TIEN3915/GIMBAL/STM32F4_GIMBAL_BOARD/Images/Ảnh chụp màn hình 2024-11-24 223947.png

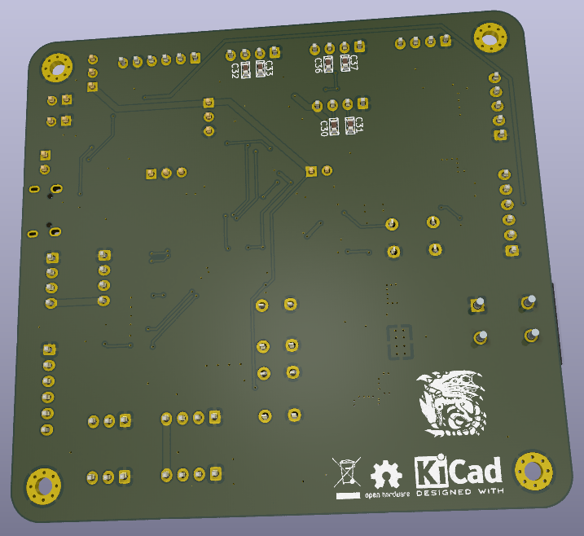
STM32F4_GIMBAL_BOARD/Images/Ảnh chụp màn hình 2024-11-24 223947.png
