TIEN3915/GIMBAL/STM32F4_GIMBAL_BOARD/STM32F4_GIMBAL_BOARD.kicad_pcb

## KiCad design STM32F4_GIMBAL_BOARD/STM32F4_GIMBAL_BOARD.kicad_pcb (2024-12-04)

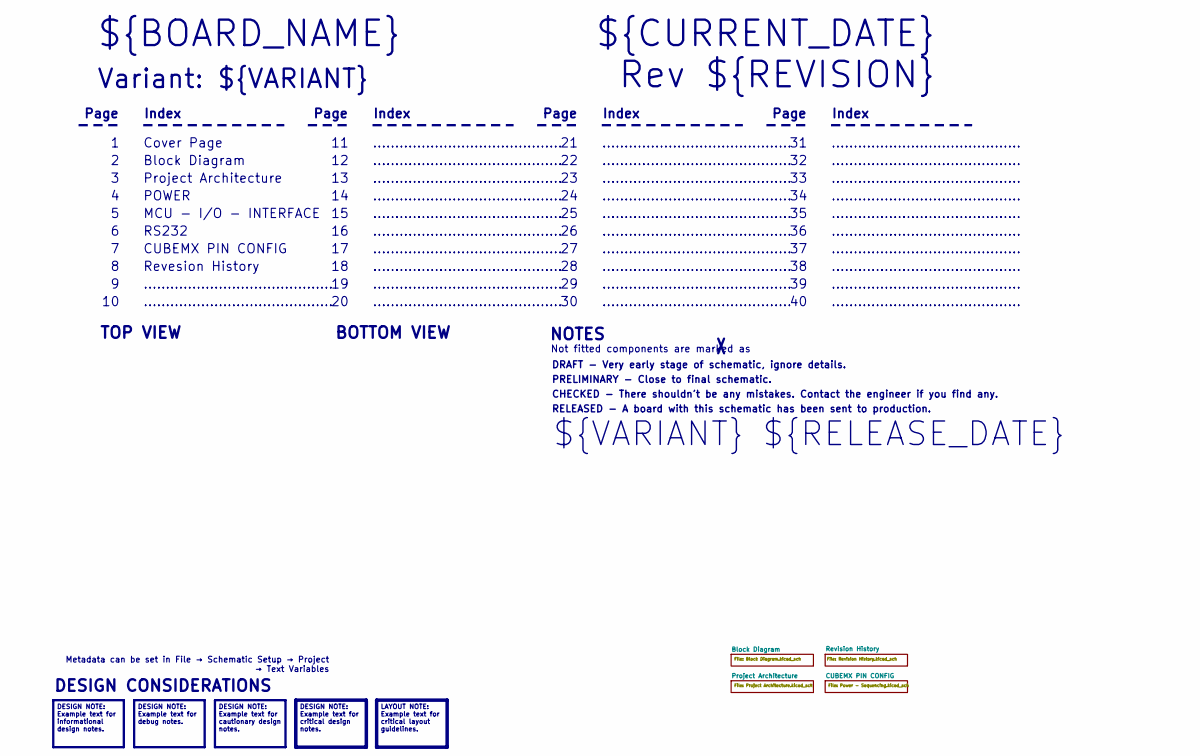
[picture p3: schematic STM32F4_GIMBAL_BOARD.kicad_sch, Cover Page]

Notes on the sheet:
Metadata can be set in File → Schematic Setup → Project → Text Variables
DESIGN NOTE: Example text for informational design notes.
LAYOUT NOTE: Example text for critical layout guidelines.
DESIGN NOTE: Example text for cautionary design notes.
DESIGN NOTE: Example text for debug notes.
DESIGN NOTE: Example text for critical design notes.
BOTTOM VIEW
...........................................
RELEASED - A board with this schematic has been sent to production.
Page
TOP VIEW
Revesion History
Not fitted components are marked as
Index
PRELIMINARY - Close to final schematic.
${VARIANT} ${RELEASE_DATE}
POWER
${CURRENT_DATE}
Variant: ${VARIANT}
Rev ${REVISION}
MCU - I/O - INTERFACE
${BOARD_NAME}
DRAFT - Very early stage of schematic, ignore details.
RS232
Block Diagram
Cover Page
NOTES
Project Architecture
CHECKED - There shouldn't be any mistakes. Contact the engineer if you find any.
DESIGN CONSIDERATIONS
CUBEMX PIN CONFIG

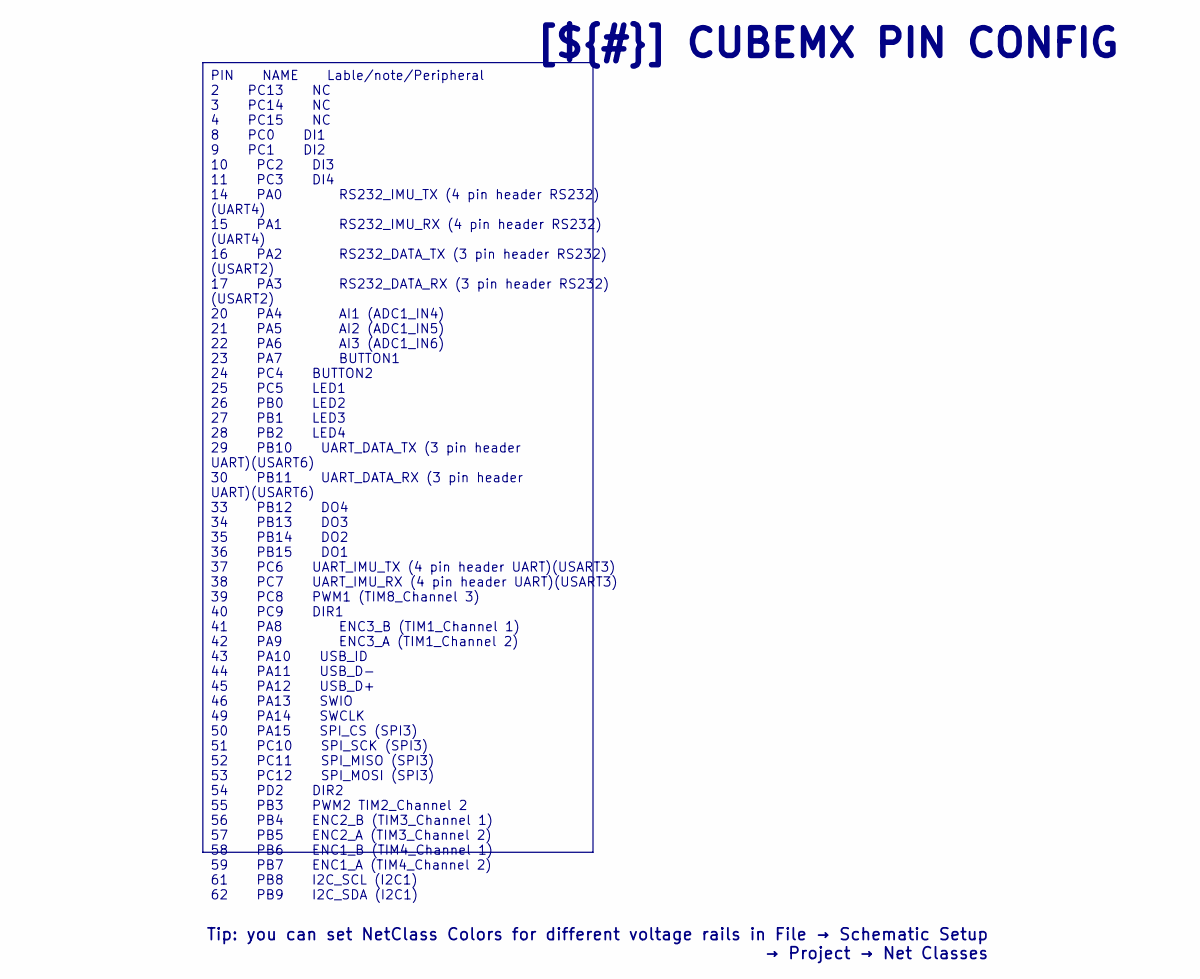
[picture p4: schematic Power - Sequencing.kicad_sch, CUBEMX PIN CONFIG]

Notes on the sheet:
PIN NAME Lable/note/Peripheral 2 PC13 NC 3 PC14 NC 4 PC15 NC 8 PC0 DI1 9 PC1 DI2 10 PC2 DI3 11 PC3 DI4 14 PA0 RS232_IMU_TX (4 pin header RS232) (UART4) 15 PA1 RS232_IMU_RX (4 pin header RS232) (UART4) 16 PA2 RS232_DATA_TX (3 pin header RS232) (USART2) 17 PA3 RS232_DATA_RX (3 pin header RS232) (USAR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
[${#}] ${TITLE}
Tip: you can set NetClass Colors for different voltage rails in File → Schematic Setup → Project → Net Classes

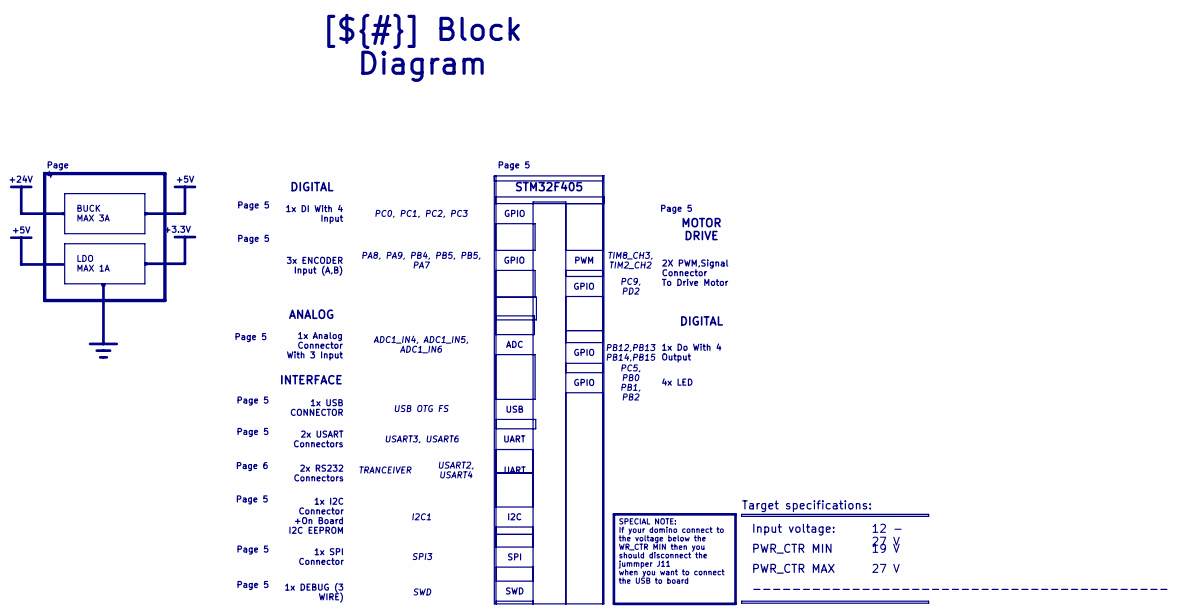
[picture p5: schematic Block Diagram.kicad_sch]

Notes on the sheet:
PWR_CTR MAX
LDO MAX 1A
GPIO
TRANCEIVER
GPIO
Page 6
PWR_CTR MIN
PA8, PA9, PB4, PB5, PB5, PA7
STM32F405
USART3, USART6
PC5, PB0 PB1, PB2
1x I2C Connector +On Board I2C EEPROM
Page 5
TIM8_CH3, TIM2_CH2
2x USART Connectors
Input voltage:
PC0, PC1, PC2, PC3
UART
19 V
SWD
PC9, PD2
1x Analog Connector With 3 Input
ADC1_IN4, ADC1_IN5, ADC1_IN6
MOTOR DRIVE
1x DEBUG (3 WIRE)
SPI
1x DI With 4 Input
SWD
1x SPI Connector
4x LED
USART2, USART4
2X PWM,Signal Connector To Drive Motor
Page 5
[${#}] ${TITLE}
Page 4
Target specifications:
SPI3
2x RS232 Connectors
27 V
ADC
DIGITAL
SPECIAL NOTE: If your domino connect to the voltage below the WR_CTR MIN then you should disconnect the jummper J11 when you want to connect the USB to board
INTERFACE
12 - 27 V
I2C
USB
PB12,PB13 PB14,PB15
1x USB CONNECTOR
USB OTG FS
PWM
3x ENCODER Input (A,B)
ANALOG
I2C1
------------------------------------------
BUCK MAX 3A
1x Do With 4 Output
+5V
+3.3V
+24V

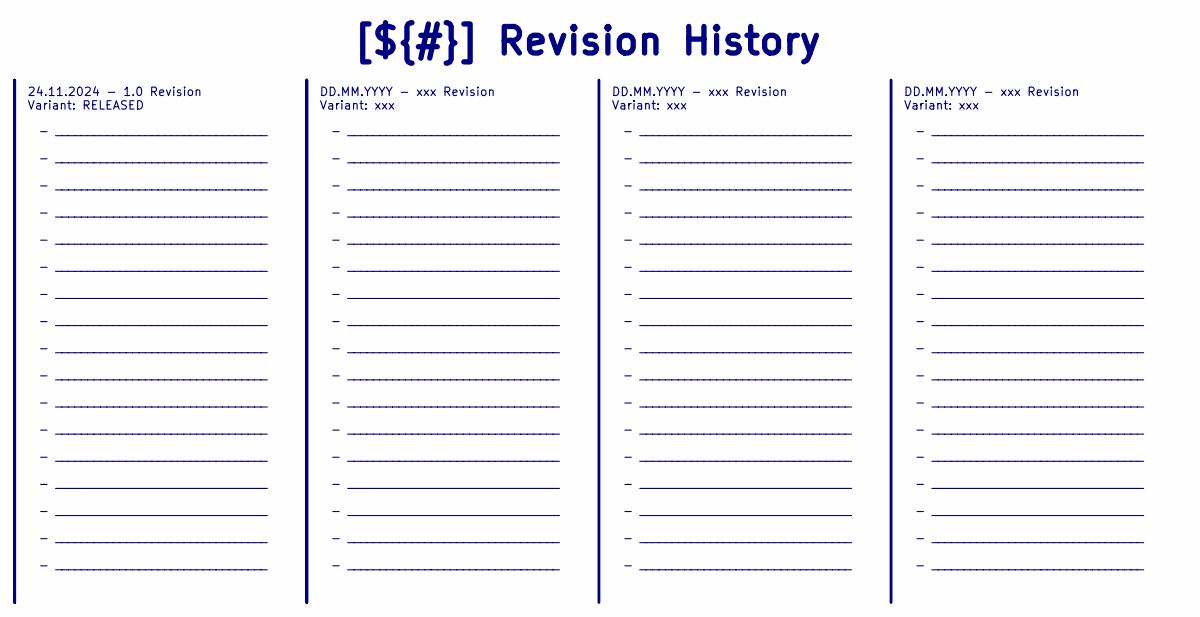
[picture p6: schematic Revision History.kicad_sch]

Notes on the sheet:
- _________________________________ - _________________________________ - _________________________________ - _________________________________ - _________________________________ - _________________________________ - _________________________________ - _________________________________ - _________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
DD.MM.YYYY - xxx Revision Variant: xxx
[${#}] ${TITLE}
24.11.2024 - 1.0 Revision Variant: RELEASED

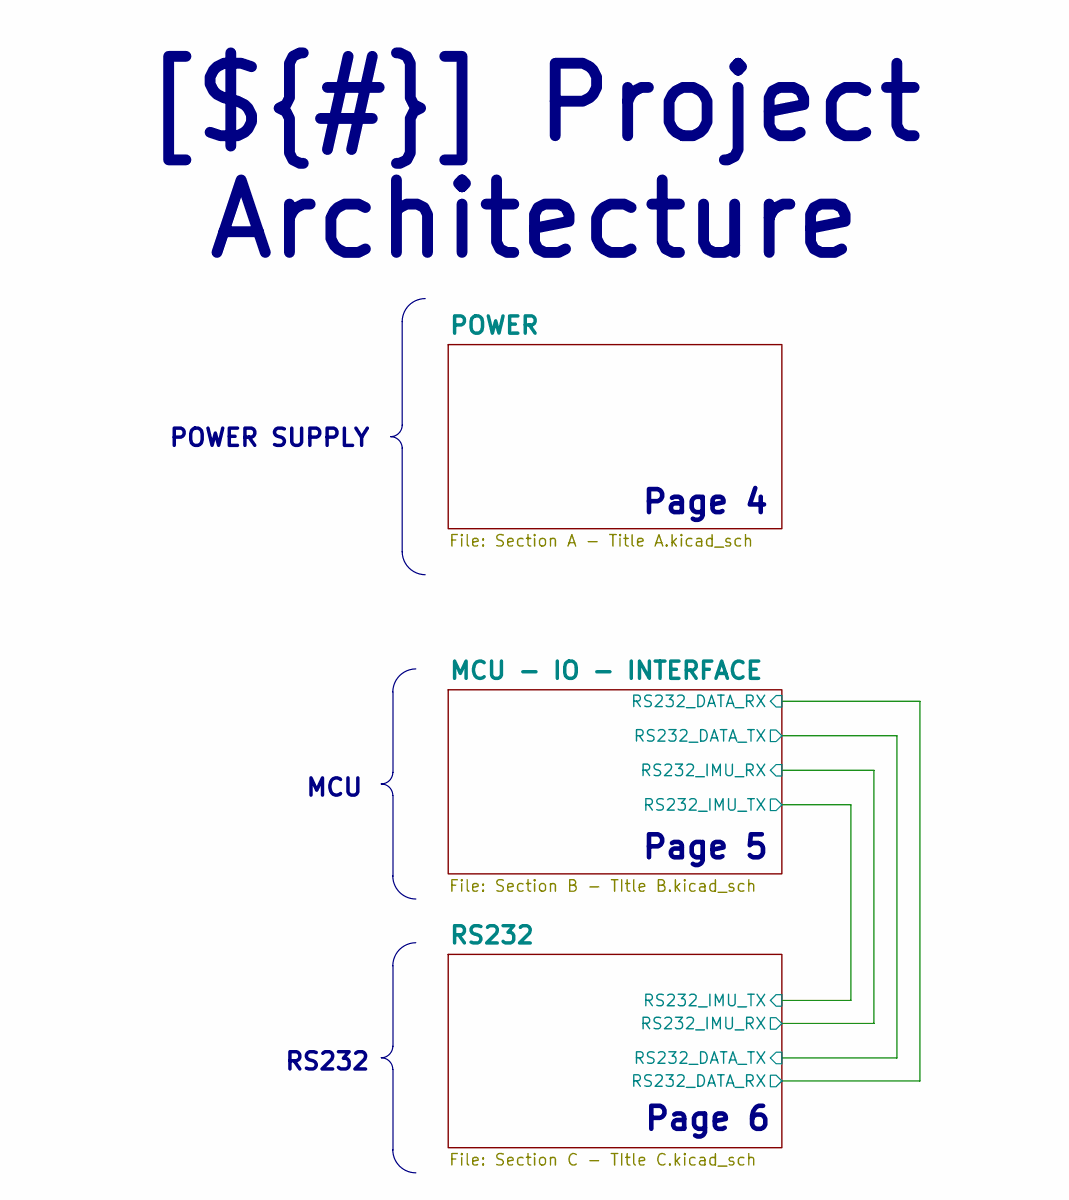
[picture p7: schematic Project Architecture.kicad_sch]

Notes on the sheet:
RS232
POWER SUPPLY
[${#}] ${TITLE}
MCU
Page 4
Page 6
Page 5

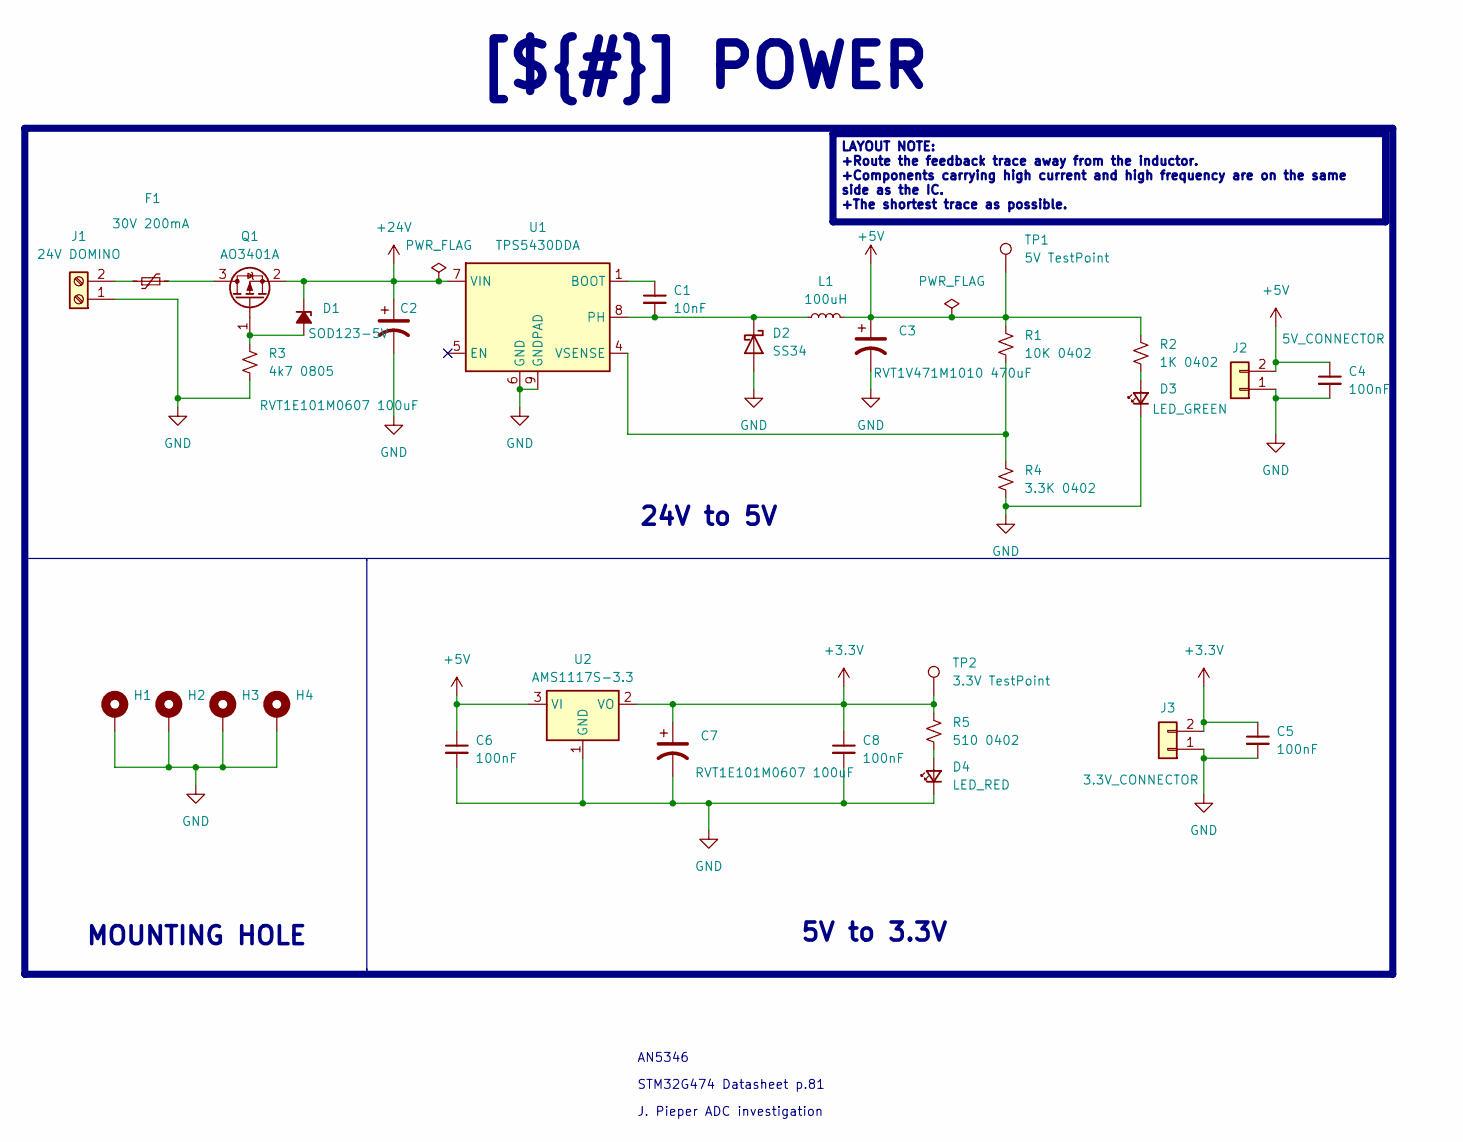
[picture p8: schematic Section A - Title A.kicad_sch, POWER]

Parts:
C1: 10nF; C_0402_1005Metric
C2, C7: RVT1E101M0607 100uF; CP_Elec_6.3x7.7
C3: RVT1V471M1010 470uF; CP_Elec_10x10.5
C4, C5, C6, C8: 100nF; C_0402_1005Metric
D1: SOD123-5V; D_SOD-123
D2: SS34; D_SMA
D3: LED_GREEN; LED_0603_1608Metric
D4: LED_RED; LED_0603_1608Metric
F1: 30V 200mA; Fuse_1812_4532Metric
H1, H2, H3, H4: MountingHole_Pad; MountingHole_2.7mm_M2.5_Pad_Via
J1: 24V DOMINO; KF142R5082P
J2: 5V_CONNECTOR; PinHeader_1x02_P2.54mm_Vertical
J3: 3.3V_CONNECTOR; PinHeader_1x02_P2.54mm_Vertical
L1: 100uH; L_12x12mm_H8mm
Q1: AO3401A; SOT-23
R1: 10K 0402; R_0402_1005Metric
R2: 1K 0402; R_0402_1005Metric
R3: 4k7 0805; R_0805_2012Metric
R4: 3.3K 0402; R_0402_1005Metric
R5: 510 0402; R_0402_1005Metric
TP1: 5V TestPoint; TestPoint_Pad_2.0x2.0mm
TP2: 3.3V TestPoint; TestPoint_Pad_2.0x2.0mm
U1: TPS5430DDA; TI_SO-PowerPAD-8_ThermalVias
U2: AMS1117S-3.3; SOT-223-3_TabPin2

Connections:
+3.3V: C5.1, C7.1, C8.1, J3.2, R5.1, TP2.1, U2.2 (VO); also elsewhere on the board
+5V: C3.1, C4.1, C6.1, J2.2, L1.2, R1.1, R2.1, TP1.1, U2.3 (VI); also elsewhere on the board
+24V: C2.1, D1.1 (K), Q1.2 (S), U1.7 (VIN); also elsewhere on the board
GND: C2.2, C3.2, C4.2, C5.2, C6.2, C7.2, C8.2, D2.2 (A), D3.1 (K), D4.1 (K), H1.1, H2.1, H3.1, H4.1, J1.1, J2.1, J3.1, R3.2, R4.2, U1.6 (GND), U1.9 (GNDPAD), U2.1 (GND); also elsewhere on the board
unnamed: D1.2 (A), Q1.1 (G), R3.1
unnamed: C1.2, D2.1 (K), L1.1, U1.8 (PH)
unnamed: D3.2 (A), R2.2
unnamed: D4.2 (A), R5.2
unnamed: F1.1, J1.2
unnamed: F1.2, Q1.3 (D)
unnamed: C1.1, U1.1 (BOOT)
unnamed: R1.2, R4.1, U1.4 (VSENSE)

Notes on the sheet:
MOUNTING HOLE
LAYOUT NOTE: +Route the feedback trace away from the inductor. +Components carrying high current and high frequency are on the same side as the IC. +The shortest trace as possible.
[${#}] ${TITLE}
5V to 3.3V
24V to 5V
J. Pieper ADC investigation
STM32G474 Datasheet p.81
AN5346

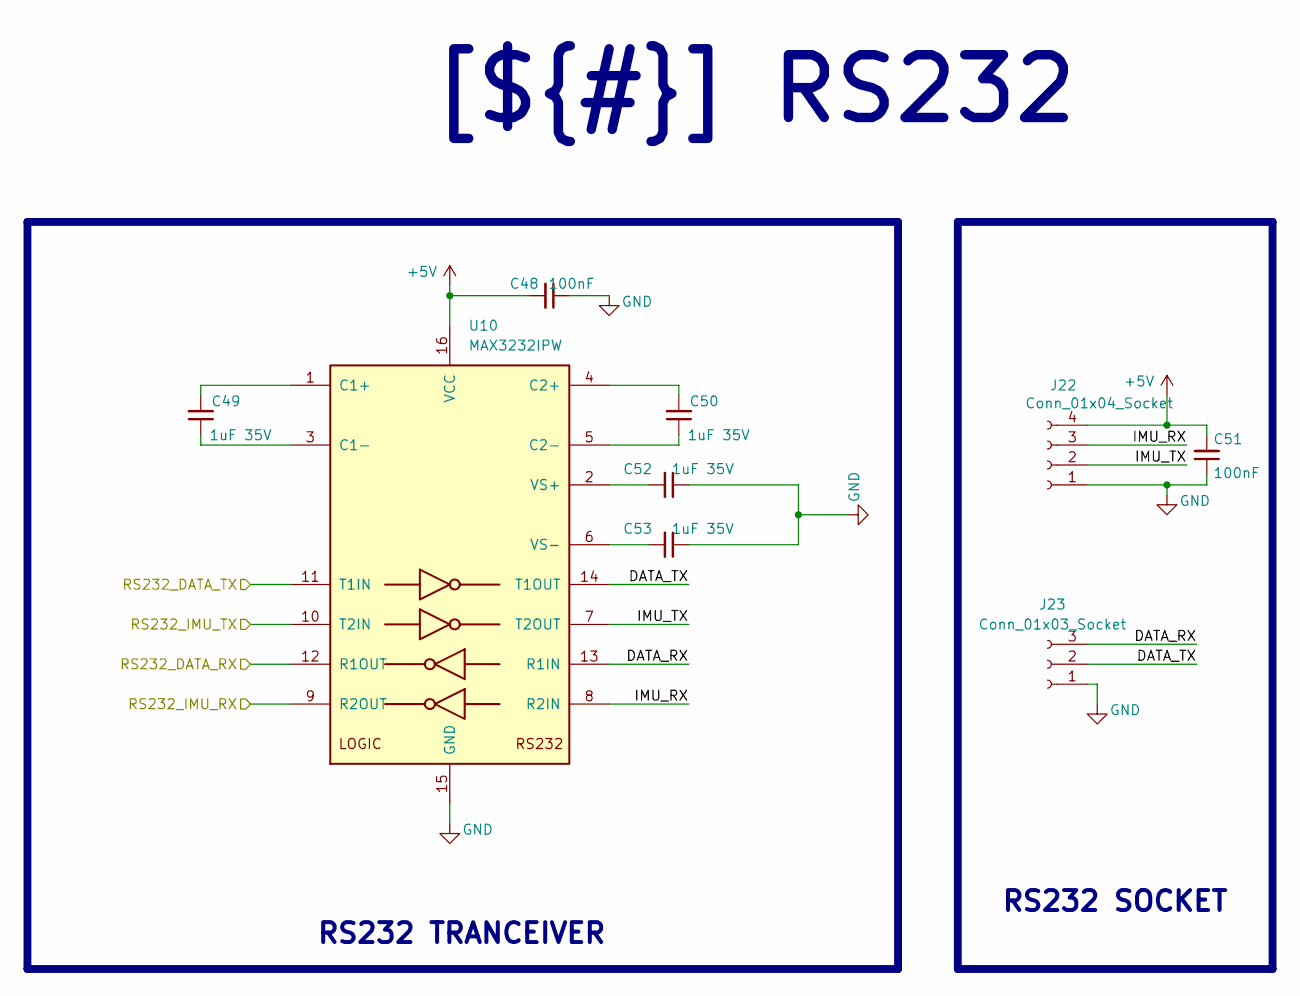
[picture p9: schematic Section C - TItle C.kicad_sch, RS232]

Parts:
C48, C51: 100nF; C_0402_1005Metric
C49, C50, C52, C53: 1uF 35V; C_0603_1608Metric
J22: Conn_01x04_Socket; JST_XH_B4B-XH-A_1x04_P2.50mm_Vertical
J23: Conn_01x03_Socket; JST_XH_B3B-XH-A_1x03_P2.50mm_Vertical
U10: MAX3232IPW; TSSOP-16_4.4x5mm_P0.65mm

Connections:
+5V: C48.2, C51.2, J22.4, U10.16 (VCC); also elsewhere on the board
/Project Architecture/MCU - IO - INTERFACE/RS232_DATA_RX: U10.12 (R1OUT); also elsewhere on the board
/Project Architecture/MCU - IO - INTERFACE/RS232_DATA_TX: U10.11 (T1IN); also elsewhere on the board
/Project Architecture/MCU - IO - INTERFACE/RS232_IMU_RX: U10.9 (R2OUT); also elsewhere on the board
/Project Architecture/MCU - IO - INTERFACE/RS232_IMU_TX: U10.10 (T2IN); also elsewhere on the board
/Project Architecture/RS232/DATA_RX: J23.3, U10.13 (R1IN)
/Project Architecture/RS232/DATA_TX: J23.2, U10.14 (T1OUT)
/Project Architecture/RS232/IMU_RX: J22.3, U10.8 (R2IN)
/Project Architecture/RS232/IMU_TX: J22.2, U10.7 (T2OUT)
GND: C48.1, C51.1, C52.1, C53.1, J22.1, J23.1, U10.15 (GND); also elsewhere on the board
unnamed: C49.2, U10.1 (C1+)
unnamed: C49.1, U10.3 (C1-)
unnamed: C50.2, U10.4 (C2+)
unnamed: C50.1, U10.5 (C2-)
unnamed: C52.2, U10.2 (VS+)
unnamed: C53.2, U10.6 (VS-)

Notes on the sheet:
RS232 TRANCEIVER
RS232 SOCKET
[${#}] ${TITLE}

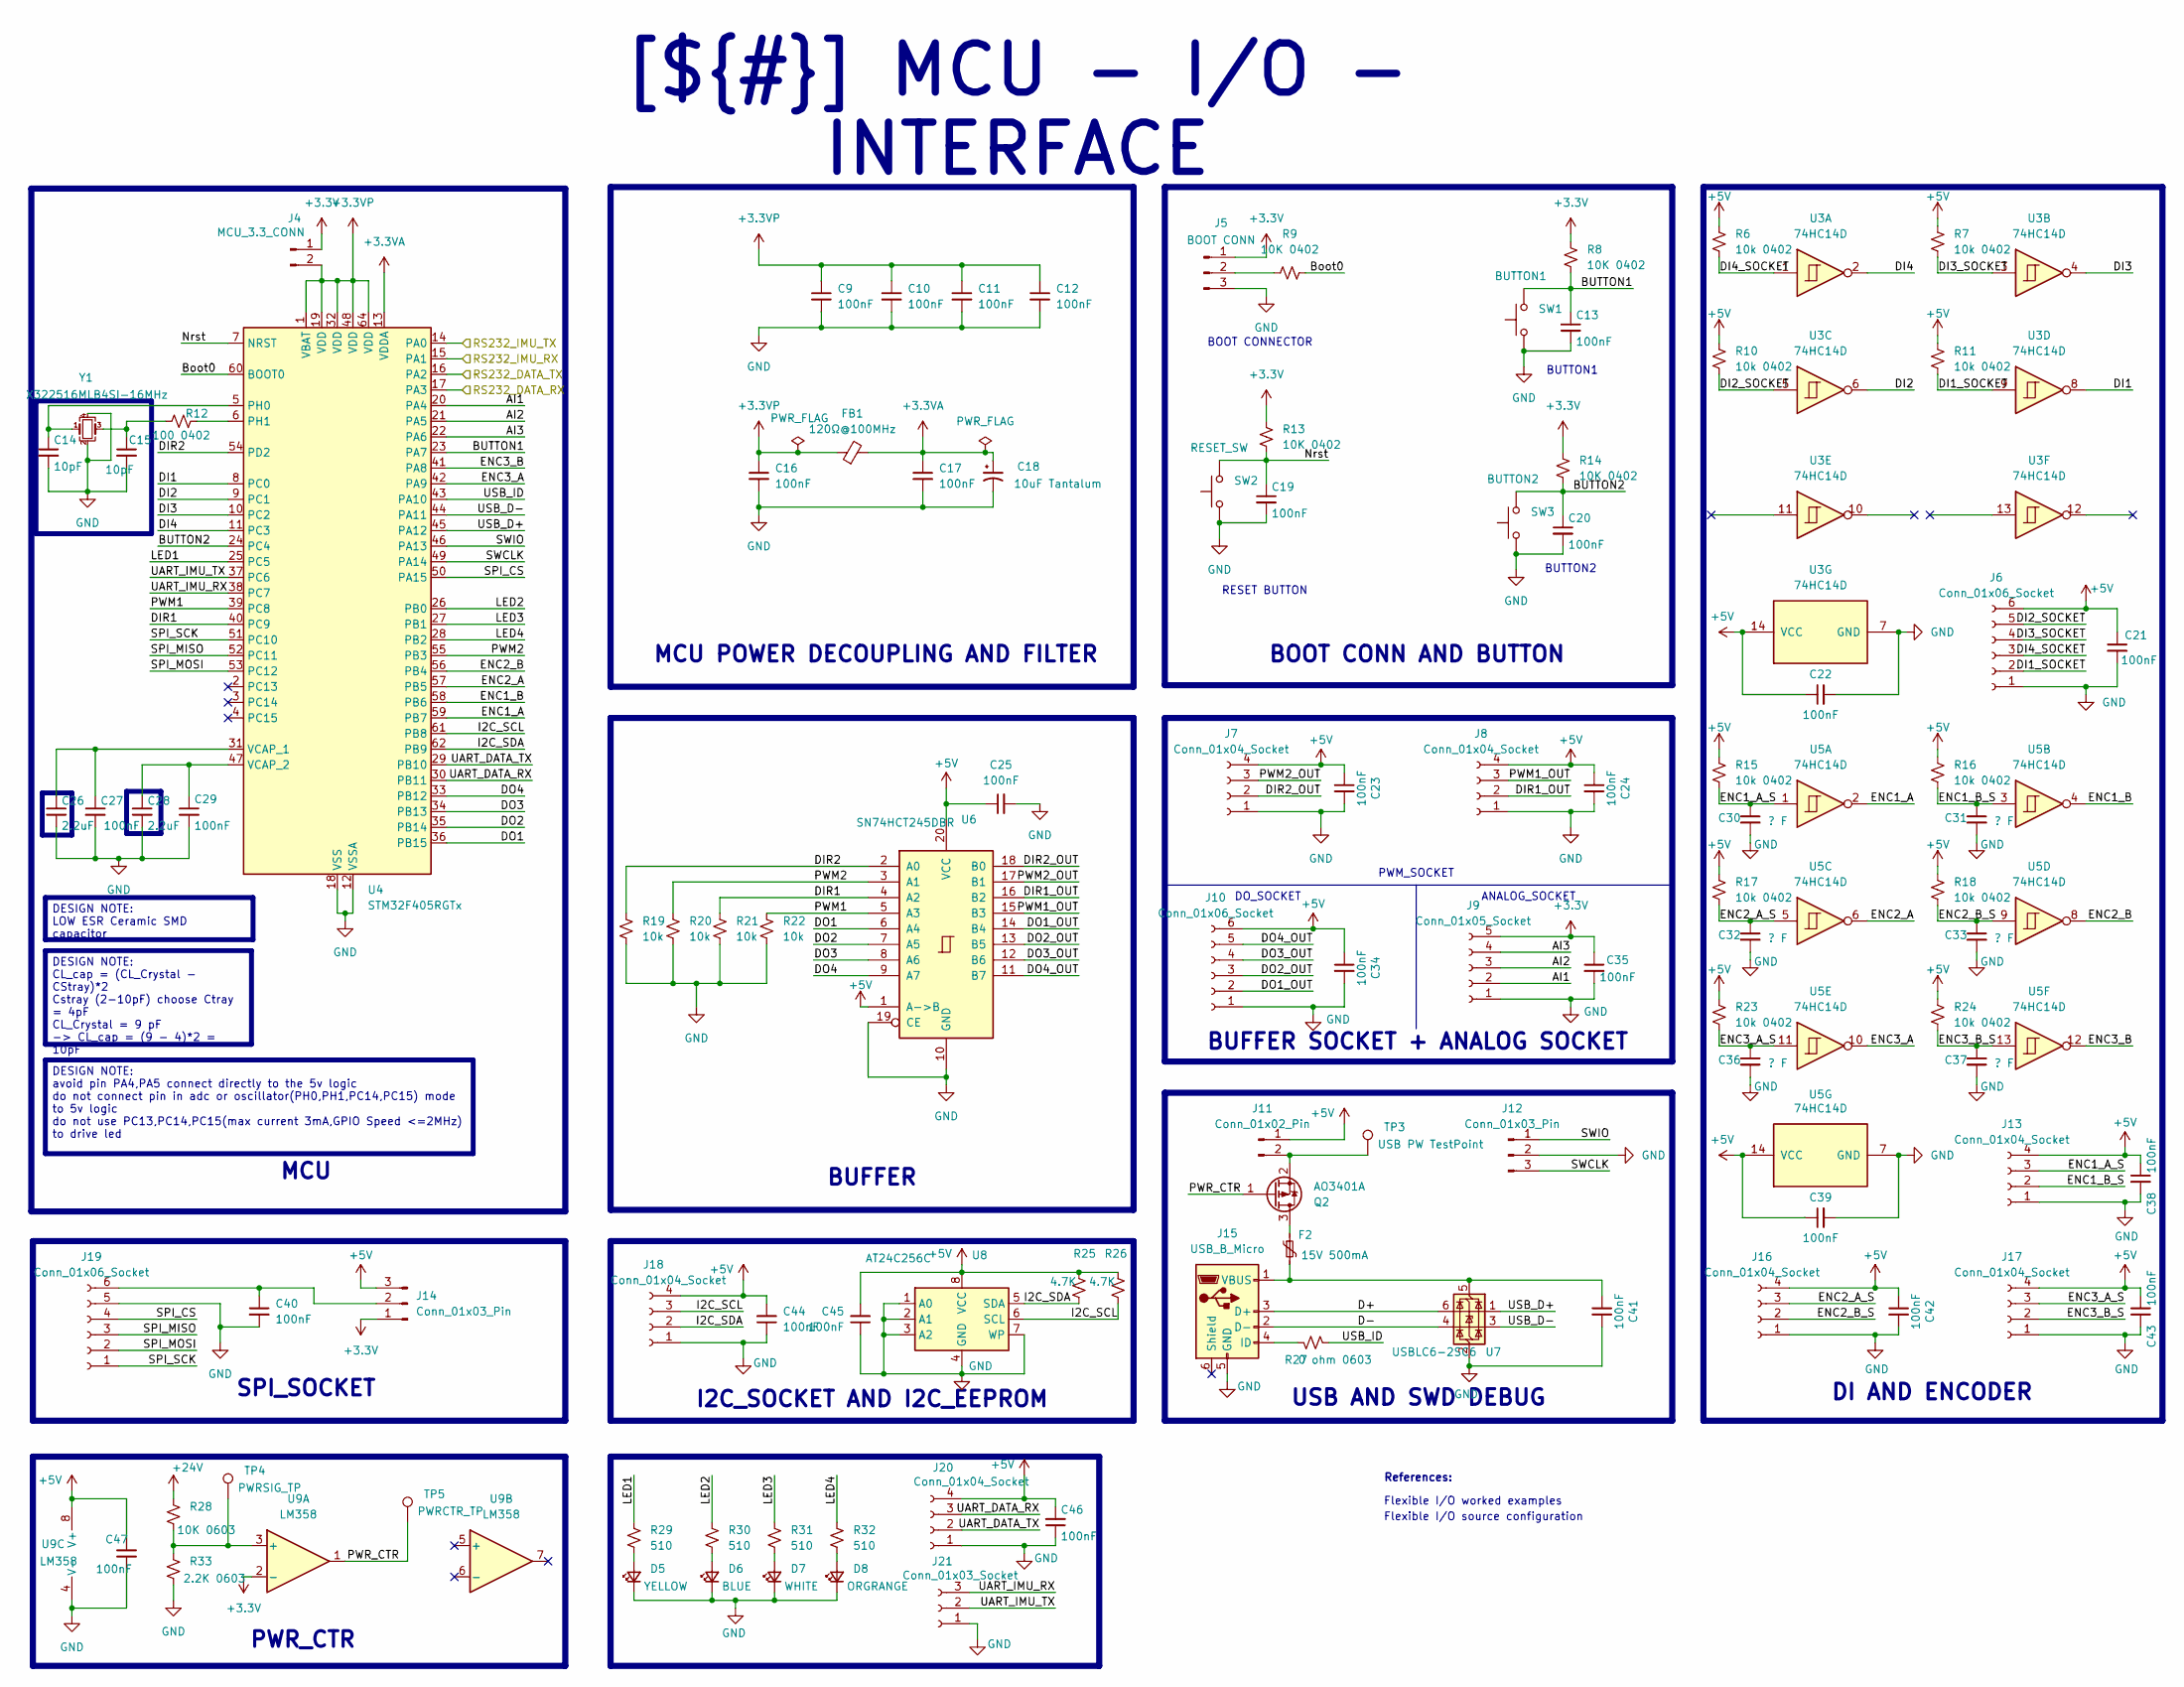
[picture p10: schematic Section B - TItle B.kicad_sch, MCU - I/O - INTERFACE]

Parts:
C9, C10, C11, C12, C13, C16, C17, C19, C20, C21, C22, C23, C24, C25, C27, C29, C34, C35, C38, C39, C40, C41, C42, C43, C44, C45, C46, C47: 100nF; C_0402_1005Metric
C14, C15: 10pF; C_0402_1005Metric
C18: 10uF Tantalum; CP_EIA-3216-18_Kemet-A_Pad1.58x1.35mm_HandSolder
C26, C28: 2.2uF; C_0402_1005Metric
C30, C31, C32, C33, C36, C37: ? F; C_0603_1608Metric
D5: YELLOW; LED_0603_1608Metric
D6: BLUE; LED_0603_1608Metric
D7: WHITE; LED_0603_1608Metric
D8: ORGRANGE; LED_0603_1608Metric
F2: 15V 500mA; Fuse_1812_4532Metric
FB1: 120Ω@100MHz; L_0603_1608Metric
J4: MCU_3.3_CONN; PinHeader_1x02_P2.54mm_Vertical
J5: BOOT CONN; PinHeader_1x03_P2.54mm_Vertical
J6, J10, J19: Conn_01x06_Socket; JST_XH_B6B-XH-A_1x06_P2.50mm_Vertical
J7, J8, J13, J16, J17, J18, J20: Conn_01x04_Socket; JST_XH_B4B-XH-A_1x04_P2.50mm_Vertical
J9: Conn_01x05_Socket; JST_XH_B5B-XH-A_1x05_P2.50mm_Vertical
J11: Conn_01x02_Pin; PinHeader_1x02_P2.54mm_Vertical
J12, J14: Conn_01x03_Pin; PinHeader_1x03_P2.54mm_Vertical
J15: USB_B_Micro; USB_Micro-B_Wuerth_629105150521
J21: Conn_01x03_Socket; JST_XH_B3B-XH-A_1x03_P2.50mm_Vertical
Q2: AO3401A; SOT-23
R6, R7, R10, R11, R15, R16, R17, R18, R23, R24: 10k 0402; R_0402_1005Metric
R8, R9, R13, R14: 10K 0402; R_0402_1005Metric
R12: 100 0402; R_0402_1005Metric
R19, R20, R21, R22: 10k; R_0402_1005Metric
R25, R26: 4.7K; R_0402_1005Metric
R27: 0 ohm 0603; R_0603_1608Metric_Pad0.98x0.95mm_HandSolder
R28: 10K 0603; R_0603_1608Metric
R29, R30, R31, R32: 510; R_0402_1005Metric
R33: 2.2K 0603; R_0603_1608Metric
SW1: BUTTON1; SW_PUSH_6mm
SW2: RESET_SW; SW_PUSH_6mm
SW3: BUTTON2; SW_PUSH_6mm
TP3: USB PW TestPoint; TestPoint_Pad_2.0x2.0mm
TP4: PWRSIG_TP; TestPoint_Pad_2.0x2.0mm
TP5: PWRCTR_TP; TestPoint_Pad_2.0x2.0mm
U3, U5: 74HC14D; SOIC-14_3.9x8.7mm_P1.27mm
U4: STM32F405RGTx; LQFP-64_10x10mm_P0.5mm
U6: SN74HCT245DBR; SSOP-20_5.3x7.2mm_P0.65mm
U7: USBLC6-2SC6; SOT-23-6
U8: AT24C256C; SOIC-8_3.9x4.9mm_P1.27mm
U9: LM358; SOIC-8_3.9x4.9mm_P1.27mm
Y1: X322516MLB4SI-16MHz; Crystal_SMD_3225-4Pin_3.2x2.5mm

Connections:
+3.3V: C35.1, J4.1, J5.1, J9.5, J14.1, R8.1, R13.1, R14.1, U9.2 (-); also elsewhere on the board
+3.3VA: C17.1, C18.1, FB1.2, U4.13 (VDDA)
+3.3VP: C9.1, C10.1, C11.1, C12.1, C16.1, FB1.1, J4.2, U4.1 (VBAT), U4.19 (VDD), U4.32 (VDD), U4.48 (VDD), U4.64 (VDD)
+5V: C21.1, C22.1, C23.1, C24.1, C25.1, C34.1, C38.1, C39.1, C42.1, C43.1, C44.2, C45.2, C46.2, C47.1, J6.6, J7.4, J8.4, J10.6, J11.1, J13.4, J14.3, J16.4, J17.4, J18.4, J20.4, R6.1, R7.1, R10.1, R11.1, R15.1, R16.1, R17.1, R18.1, R23.1, R24.1, R25.1, R26.1, U3.14 (VCC), U5.14 (VCC), U6.1 (A->B), U6.20 (VCC), U8.8 (VCC), U9.8 (V+); also elsewhere on the board
+24V: R28.1; also elsewhere on the board
/Project Architecture/MCU - IO - INTERFACE/AI1: J9.2, U4.20 (PA4)
/Project Architecture/MCU - IO - INTERFACE/AI2: J9.3, U4.21 (PA5)
/Project Architecture/MCU - IO - INTERFACE/AI3: J9.4, U4.22 (PA6)
/Project Architecture/MCU - IO - INTERFACE/BUTTON1: C13.1, R8.2, SW1.2, U4.23 (PA7)
/Project Architecture/MCU - IO - INTERFACE/BUTTON2: C20.1, R14.2, SW3.2, U4.24 (PC4)
/Project Architecture/MCU - IO - INTERFACE/Boot0: R9.2, U4.60 (BOOT0)
/Project Architecture/MCU - IO - INTERFACE/D+: J15.3 (D+), U7.6 (I/O1)
/Project Architecture/MCU - IO - INTERFACE/D-: J15.2 (D-), U7.4 (I/O2)
/Project Architecture/MCU - IO - INTERFACE/DI1: U3.8, U4.8 (PC0)
/Project Architecture/MCU - IO - INTERFACE/DI1_SOCKET: J6.2, R11.2, U3.9
/Project Architecture/MCU - IO - INTERFACE/DI2: U3.6, U4.9 (PC1)
/Project Architecture/MCU - IO - INTERFACE/DI2_SOCKET: J6.5, R10.2, U3.5
/Project Architecture/MCU - IO - INTERFACE/DI3: U3.4, U4.10 (PC2)
/Project Architecture/MCU - IO - INTERFACE/DI3_SOCKET: J6.4, R7.2, U3.3
/Project Architecture/MCU - IO - INTERFACE/DI4: U3.2, U4.11 (PC3)
/Project Architecture/MCU - IO - INTERFACE/DI4_SOCKET: J6.3, R6.2, U3.1
/Project Architecture/MCU - IO - INTERFACE/DIR1: R21.1, U4.40 (PC9), U6.4 (A2)
/Project Architecture/MCU - IO - INTERFACE/DIR1_OUT: J8.2, U6.16 (B2)
/Project Architecture/MCU - IO - INTERFACE/DIR2: R19.1, U4.54 (PD2), U6.2 (A0)
/Project Architecture/MCU - IO - INTERFACE/DIR2_OUT: J7.2, U6.18 (B0)
/Project Architecture/MCU - IO - INTERFACE/DO1: U4.36 (PB15), U6.6 (A4)
/Project Architecture/MCU - IO - INTERFACE/DO1_OUT: J10.2, U6.14 (B4)
/Project Architecture/MCU - IO - INTERFACE/DO2: U4.35 (PB14), U6.7 (A5)
/Project Architecture/MCU - IO - INTERFACE/DO2_OUT: J10.3, U6.13 (B5)
/Project Architecture/MCU - IO - INTERFACE/DO3: U4.34 (PB13), U6.8 (A6)
/Project Architecture/MCU - IO - INTERFACE/DO3_OUT: J10.4, U6.12 (B6)
/Project Architecture/MCU - IO - INTERFACE/DO4: U4.33 (PB12), U6.9 (A7)
/Project Architecture/MCU - IO - INTERFACE/DO4_OUT: J10.5, U6.11 (B7)
/Project Architecture/MCU - IO - INTERFACE/ENC1_A: U4.59 (PB7), U5.2
/Project Architecture/MCU - IO - INTERFACE/ENC1_A_S: C30.1, J13.3, R15.2, U5.1
/Project Architecture/MCU - IO - INTERFACE/ENC1_B: U4.58 (PB6), U5.4
/Project Architecture/MCU - IO - INTERFACE/ENC1_B_S: C31.1, J13.2, R16.2, U5.3
/Project Architecture/MCU - IO - INTERFACE/ENC2_A: U4.57 (PB5), U5.6
/Project Architecture/MCU - IO - INTERFACE/ENC2_A_S: C32.1, J16.3, R17.2, U5.5
/Project Architecture/MCU - IO - INTERFACE/ENC2_B: U4.56 (PB4), U5.8
/Project Architecture/MCU - IO - INTERFACE/ENC2_B_S: C33.1, J16.2, R18.2, U5.9
/Project Architecture/MCU - IO - INTERFACE/ENC3_A: U4.42 (PA9), U5.10
/Project Architecture/MCU - IO - INTERFACE/ENC3_A_S: C36.1, J17.3, R23.2, U5.11
/Project Architecture/MCU - IO - INTERFACE/ENC3_B: U4.41 (PA8), U5.12
/Project Architecture/MCU - IO - INTERFACE/ENC3_B_S: C37.1, J17.2, R24.2, U5.13
/Project Architecture/MCU - IO - INTERFACE/I2C_SCL: J18.3, R26.2, U4.61 (PB8), U8.6 (SCL)
/Project Architecture/MCU - IO - INTERFACE/I2C_SDA: J18.2, R25.2, U4.62 (PB9), U8.5 (SDA)
/Project Architecture/MCU - IO - INTERFACE/LED1: R29.1, U4.25 (PC5)
/Project Architecture/MCU - IO - INTERFACE/LED2: R30.1, U4.26 (PB0)
/Project Architecture/MCU - IO - INTERFACE/LED3: R31.1, U4.27 (PB1)
/Project Architecture/MCU - IO - INTERFACE/LED4: R32.1, U4.28 (PB2)
/Project Architecture/MCU - IO - INTERFACE/Nrst: C19.1, R13.2, SW2.2, U4.7 (NRST)
/Project Architecture/MCU - IO - INTERFACE/PWM1: R22.1, U4.39 (PC8), U6.5 (A3)
/Project Architecture/MCU - IO - INTERFACE/PWM1_OUT: J8.3, U6.15 (B3)
/Project Architecture/MCU - IO - INTERFACE/PWM2: R20.1, U4.55 (PB3), U6.3 (A1)
/Project Architecture/MCU - IO - INTERFACE/PWM2_OUT: J7.3, U6.17 (B1)
/Project Architecture/MCU - IO - INTERFACE/PWR_CTR: Q2.1 (G), TP5.1, U9.1
/Project Architecture/MCU - IO - INTERFACE/RS232_DATA_RX: U4.17 (PA3); also elsewhere on the board
/Project Architecture/MCU - IO - INTERFACE/RS232_DATA_TX: U4.16 (PA2); also elsewhere on the board
/Project Architecture/MCU - IO - INTERFACE/RS232_IMU_RX: U4.15 (PA1); also elsewhere on the board
/Project Architecture/MCU - IO - INTERFACE/RS232_IMU_TX: U4.14 (PA0); also elsewhere on the board
/Project Architecture/MCU - IO - INTERFACE/SPI_CS: J19.4, U4.50 (PA15)
/Project Architecture/MCU - IO - INTERFACE/SPI_MISO: J19.3, U4.52 (PC11)
/Project Architecture/MCU - IO - INTERFACE/SPI_MOSI: J19.2, U4.53 (PC12)
/Project Architecture/MCU - IO - INTERFACE/SPI_SCK: J19.1, U4.51 (PC10)
/Project Architecture/MCU - IO - INTERFACE/SWCLK: J12.3, U4.49 (PA14)
/Project Architecture/MCU - IO - INTERFACE/SWIO: J12.1, U4.46 (PA13)
/Project Architecture/MCU - IO - INTERFACE/UART_DATA_RX: J20.3, U4.30 (PB11)
/Project Architecture/MCU - IO - INTERFACE/UART_DATA_TX: J20.2, U4.29 (PB10)
/Project Architecture/MCU - IO - INTERFACE/UART_IMU_RX: J21.3, U4.38 (PC7)
/Project Architecture/MCU - IO - INTERFACE/UART_IMU_TX: J21.2, U4.37 (PC6)
/Project Architecture/MCU - IO - INTERFACE/USB_D+: U4.45 (PA12), U7.1 (I/O1)
/Project Architecture/MCU - IO - INTERFACE/USB_D-: U4.44 (PA11), U7.3 (I/O2)
/Project Architecture/MCU - IO - INTERFACE/USB_ID: R27.2, U4.43 (PA10)
GND: C9.2, C10.2, C11.2, C12.2, C13.2, C14.2, C15.2, C16.2, C17.2, C18.2, C19.2, C20.2, C21.2, C22.2, C23.2, C24.2, C25.2, C26.2, C27.2, C28.2, C29.2, C30.2, C31.2, C32.2, C33.2, C34.2, C35.2, C36.2, C37.2, C38.2, C39.2, C40.2, C41.2, C42.2, C43.2, C44.1, C45.1, C46.1, C47.2, D5.1 (K), D6.1 (K), D7.1 (K), D8.1 (K), J5.3, J6.1, J7.1, J8.1, J9.1, J10.1, J12.2, J13.1, J15.5 (GND), J16.1, J17.1, J18.1, J19.5, J20.1, J21.1, R19.2, R20.2, R21.2, R22.2, R33.2, SW1.1, SW2.1, SW3.1, U3.7 (GND), U4.12 (VSSA), U4.18 (VSS), U4.63 (VSS), U5.7 (GND), U6.10 (GND), U6.19 (CE), U7.2 (GND), U8.1 (A0), U8.2 (A1), U8.3 (A2), U8.4 (GND), U8.7 (WP), U9.4 (V-), Y1.2, Y1.4; also elsewhere on the board
unnamed: C15.1, R12.1, Y1.3
unnamed: D5.2 (A), R29.2
unnamed: D6.2 (A), R30.2
unnamed: D7.2 (A), R31.2
unnamed: D8.2 (A), R32.2
unnamed: J5.2, R9.1
unnamed: J11.2, Q2.2 (S), TP3.1
unnamed: C40.1, J14.2, J19.6
unnamed: J15.4 (ID), R27.1
unnamed: C41.1, F2.2, J15.1 (VBUS), U7.5 (VBUS)
unnamed: F2.1, Q2.3 (D)
unnamed: C14.1, U4.5 (PH0), Y1.1
unnamed: R12.2, U4.6 (PH1)
unnamed: C26.1, C27.1, U4.31 (VCAP_1)
unnamed: C28.1, C29.1, U4.47 (VCAP_2)
unnamed: R28.2, R33.1, TP4.1, U9.3 (+)

Notes on the sheet:
BOOT CONN AND BUTTON
I2C_SOCKET AND I2C_EEPROM
[${#}] ${TITLE}
SPI_SOCKET
DESIGN NOTE: CL_cap = (CL_Crystal - CStray)*2 Cstray (2-10pF) choose Ctray = 4pF CL_Crystal = 9 pF -> CL_cap = (9 - 4)*2 = 10pF
USB AND SWD DEBUG
MCU
MCU POWER DECOUPLING AND FILTER
BUFFER SOCKET + ANALOG SOCKET
PWR_CTR
DI AND ENCODER
DESIGN NOTE: LOW ESR Ceramic SMD capacitor
DESIGN NOTE: avoid pin PA4,PA5 connect directly to the 5v logic do not connect pin in adc or oscillator(PH0,PH1,PC14,PC15) mode to 5v logic do not use PC13,PC14,PC15(max current 3mA,GPIO Speed <=2MHz) to drive led
BUFFER
Flexible I/O worked examples
BOOT CONNECTOR
PWM_SOCKET
BUTTON2
ANALOG_SOCKET
RESET BUTTON
DO_SOCKET
References:
BUTTON1
Flexible I/O source configuration
