TIEN3915/GIMBAL/STM32F4_GIMBAL_BOARD/STM32F4_GIMBAL_BOARD.kicad_pcb

## KiCad design STM32F4_GIMBAL_BOARD/STM32F4_GIMBAL_BOARD.kicad_pcb (continued)

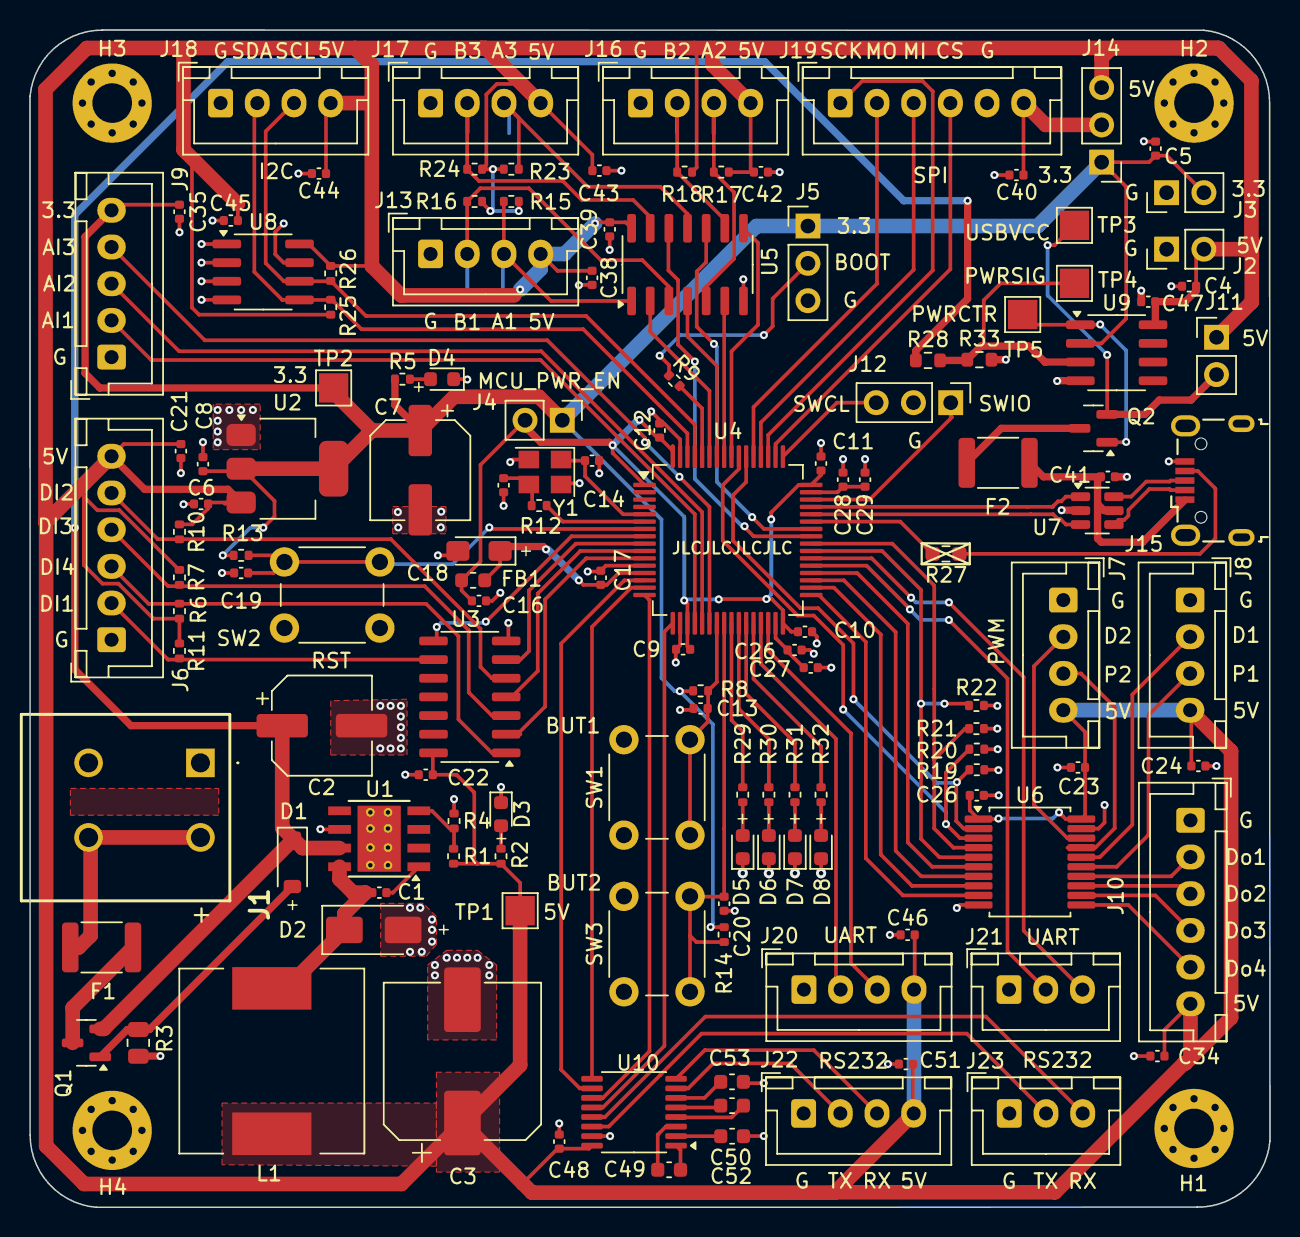
[picture p11: board STM32F4_GIMBAL_BOARD.kicad_pcb from above]

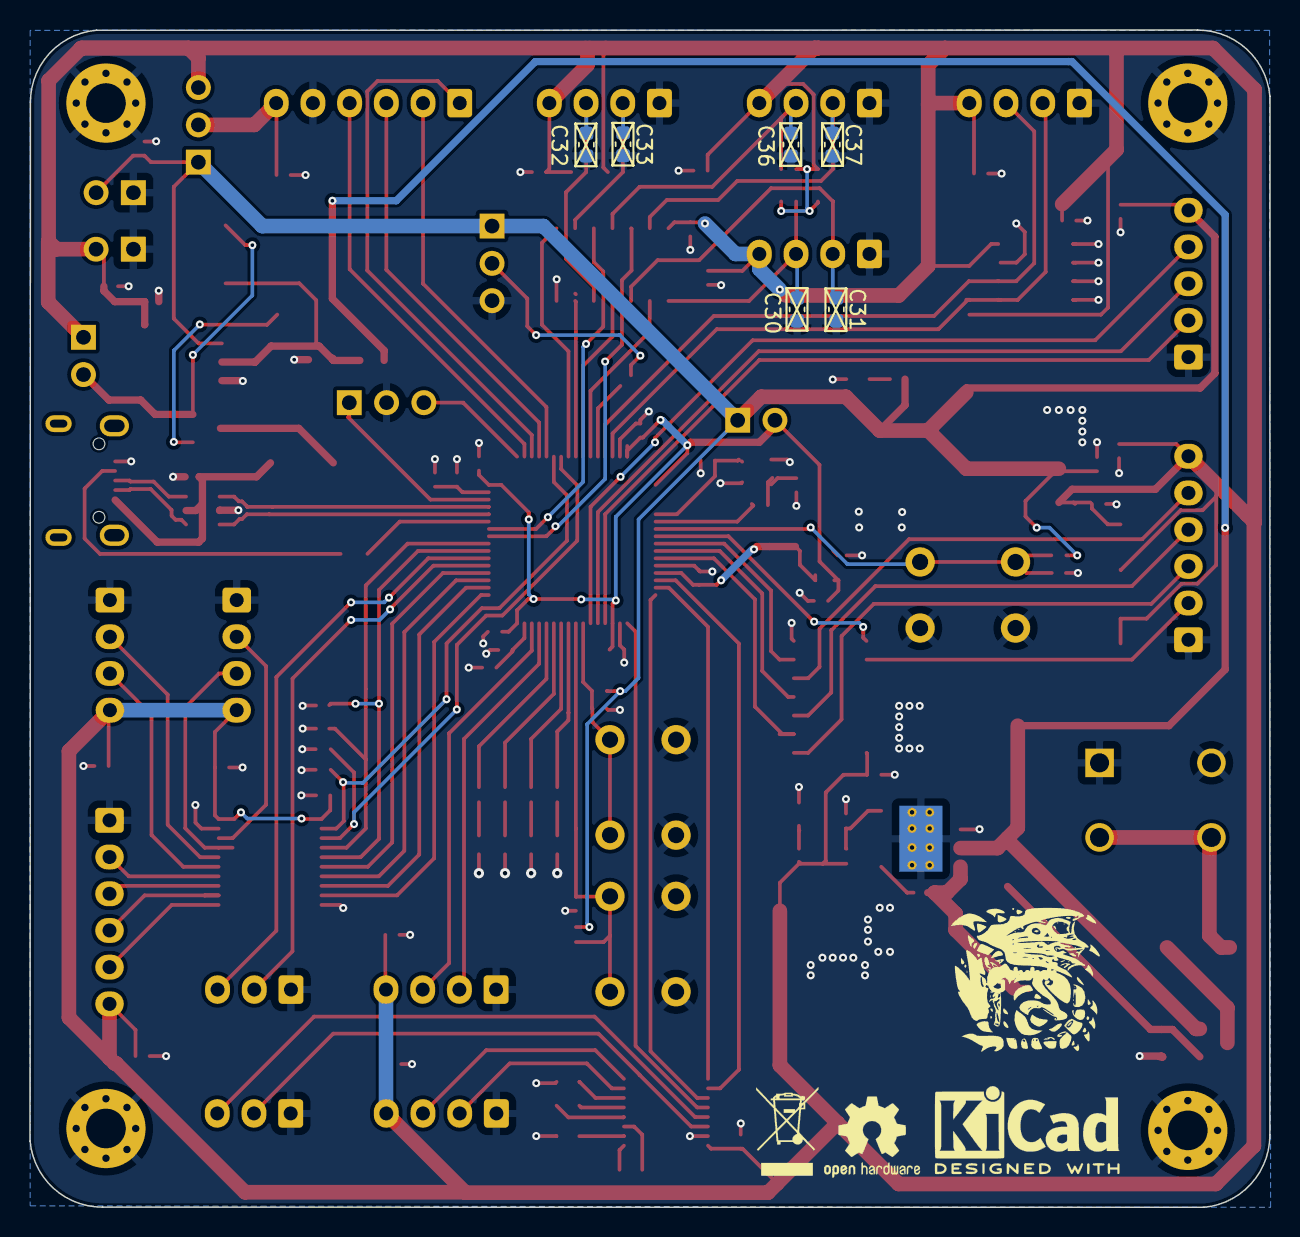
[picture p12: board STM32F4_GIMBAL_BOARD.kicad_pcb from below]

Board: 2 copper layers, 84.4 x 80.2 mm, 146 parts (6 on the bottom side), 109 nets.
