TIEN3915/GIMBAL/STM32F4_GIMBAL_BOARD/CUBEMX_PIN/CUBEMX_PIN.ioc

Mcu.UserName=STM32F405RGTx
PA0-WKUP.Signal=UART4_TX
PA1.Signal=UART4_RX
PA11.Signal=USB_OTG_FS_DM
PA12.Signal=USB_OTG_FS_DP
PA13.Signal=SYS_JTMS-SWDIO
PA14.Signal=SYS_JTCK-SWCLK
PA15.Signal=SPI3_NSS
PA2.Signal=USART2_TX
PA3.Signal=USART2_RX
PA4.Signal=ADCx_IN4
PA5.Signal=ADCx_IN5
PA6.Signal=ADCx_IN6
PA7.GPIO_Label=GPIO_BUTTON1
PA7.Signal=GPIO_Input
PA8.GPIO_Label=TIM1_CH1_ENC3_B
PA8.Signal=S_TIM1_CH1
PA9.GPIO_Label=TIM1_CH2_ENC3_A
PA9.Signal=S_TIM1_CH2
PB0.GPIO_Label=GPIO_LED2
PB0.Signal=GPIO_Output
PB1.GPIO_Label=GPIO_LED3
PB1.Signal=GPIO_Output
PB10.Signal=USART3_TX
PB11.Signal=USART3_RX
PB12.GPIO_Label=GPIO_DO1
PB12.Signal=GPIO_Output
PB13.GPIO_Label=GPIO_DO2
PB13.Signal=GPIO_Output
PB14.GPIO_Label=GPIO_DO3
PB14.Signal=GPIO_Output
PB15.GPIO_Label=GPIO_DO4
PB15.Signal=GPIO_Output
PB2.GPIO_Label=GPIO_LED4
PB2.Signal=GPIO_Output
PB3.GPIO_Label=TIM2_CHANNEL2_PWM2
PB3.Signal=S_TIM2_CH2
PB4.GPIO_Label=TIM3_CH1_ENC2_B
PB4.Signal=S_TIM3_CH1
PB5.GPIO_Label=TIM3_CH2_ENC2_A
PB5.Signal=S_TIM3_CH2
PB6.GPIO_Label=TIM4_CH1_ENC1_B
PB6.Signal=S_TIM4_CH1
PB7.GPIO_Label=TIM4_CH2_ENC1_A
PB7.Signal=S_TIM4_CH2
PB8.Signal=I2C1_SCL
PB9.Signal=I2C1_SDA
PC0.Signal=GPXTI0
PC1.Signal=GPXTI1
PC10.Signal=SPI3_SCK
PC11.Signal=SPI3_MISO
PC12.Signal=SPI3_MOSI
PC2.Signal=GPXTI2
PC3.Signal=GPXTI3
PC4.GPIO_Label=GPIO_BUTTON2
PC4.Signal=GPIO_Input
PC5.GPIO_Label=GPIO_LED1
PC5.Signal=GPIO_Output
PC6.Signal=USART6_TX
PC7.Signal=USART6_RX
PC8.GPIO_Label=TIM8_CHANNEL3_PWM1
PC8.Signal=S_TIM8_CH3
PC9.GPIO_Label=GPIO_DIR1
PC9.Signal=GPIO_Output
PD2.GPIO_Label=GPIO_DIR2
PD2.Signal=GPIO_Output
PH0-OSC_IN.Signal=RCC_OSC_IN
PH1-OSC_OUT.Signal=RCC_OSC_OUT
